f0reachARR/music-light-stick/xiao-sch/LightStick/LightStick.kicad_pcb

## KiCad design xiao-sch/LightStick/LightStick.kicad_pcb (2026-02-07)

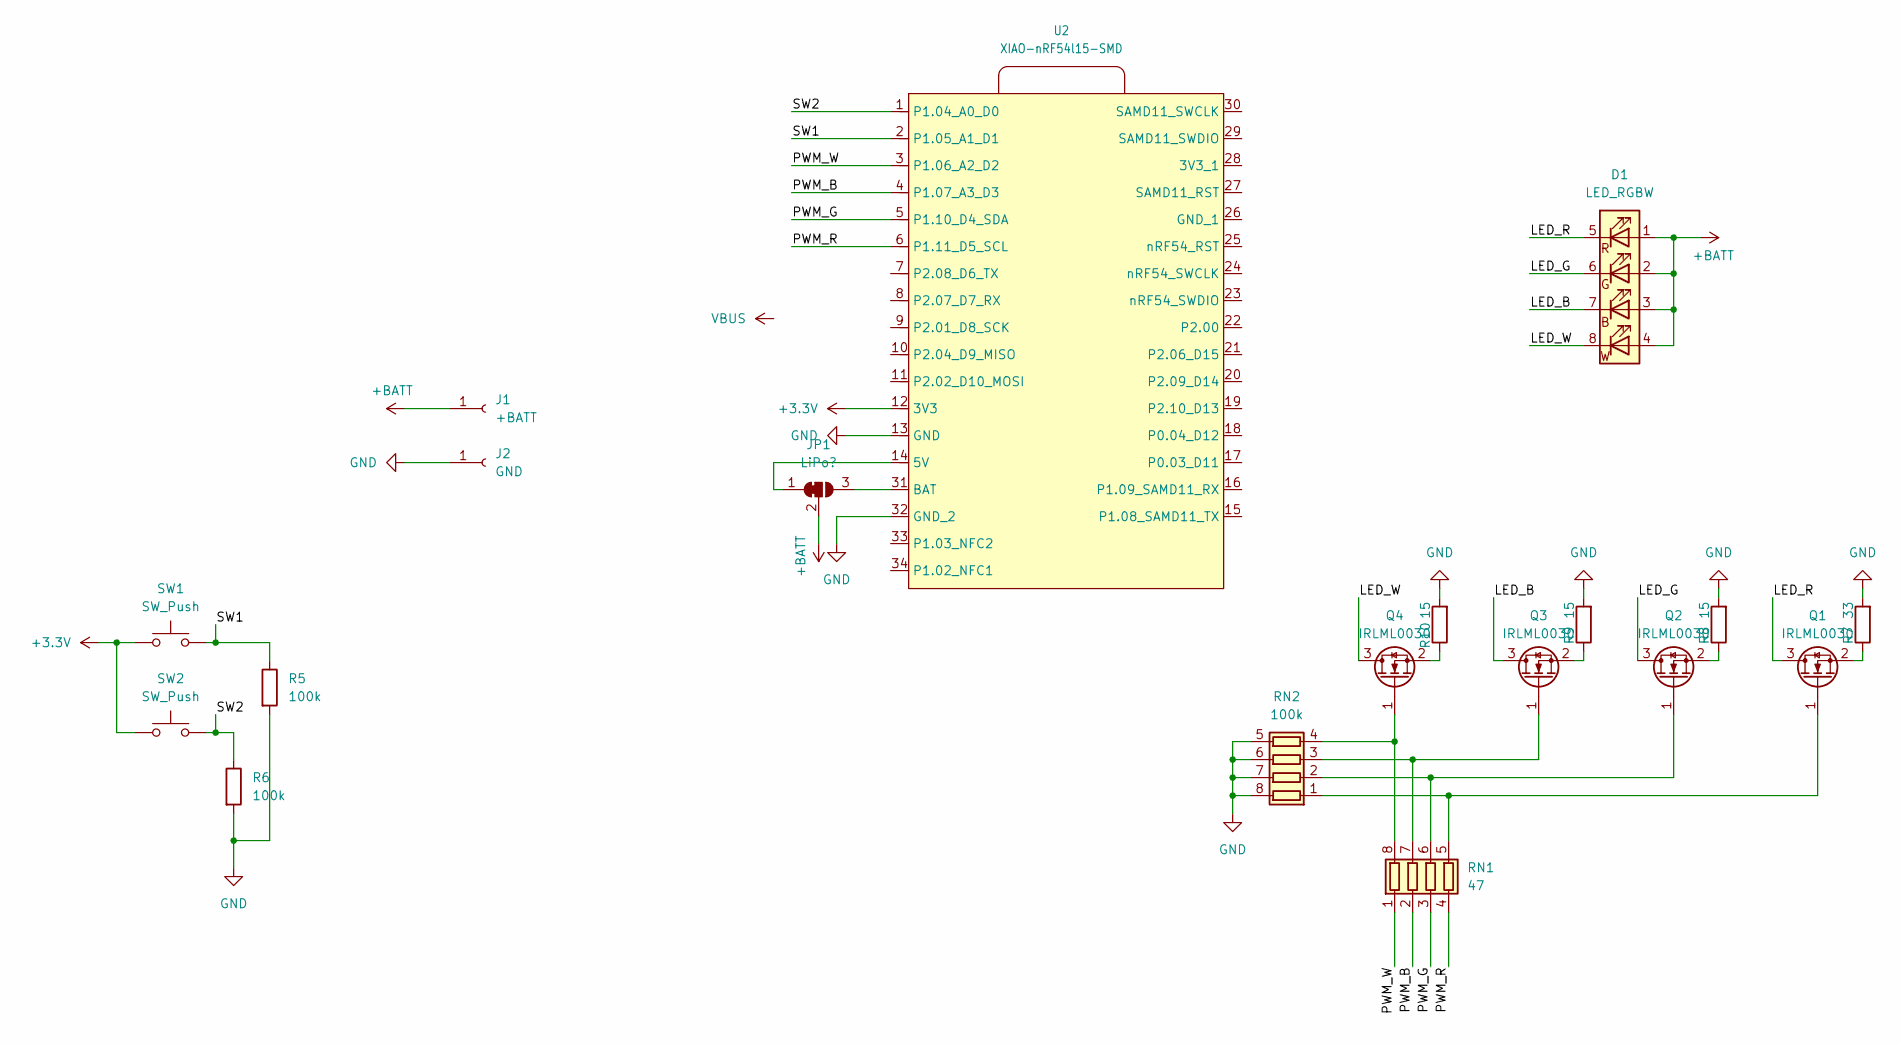
[picture p1: schematic LightStick.kicad_sch, LightStick Main]

Parts:
D1: LED_RGBW; XL-5050RGBW
J1: +BATT; TestPoint_Pad_D2.5mm
J2: GND; TestPoint_Pad_D2.5mm
JP1: LiPo?; SolderJumper-3_P1.3mm_Bridged12_RoundedPad1.0x1.5mm
Q1, Q2, Q3, Q4: IRLML0030; SOT-23
R5, R6: 100k; R_0603_1608Metric_Pad0.98x0.95mm_HandSolder
R7: 33; R_0603_1608Metric_Pad0.98x0.95mm_HandSolder
R8, R9, R10: 15; R_0603_1608Metric_Pad0.98x0.95mm_HandSolder
RN1: 47; R_Array_Concave_4x0603
RN2: 100k; R_Array_Concave_4x0603
SW1, SW2: SW_Push; SW_SPST_PTS647_Sx38
U2: XIAO-nRF54l15-SMD

Connections:
+3.3V: SW1.1, SW2.1, U2.12 (3V3)
+BATT: D1.1 (RA), D1.2 (GA), D1.3 (BA), D1.4 (WA), J1.1, JP1.2 (C)
/LED_B: D1.7 (BK), Q3.3 (D)
/LED_G: D1.6 (GK), Q2.3 (D)
/LED_R: D1.5 (RK), Q1.3 (D)
/LED_W: D1.8 (WK), Q4.3 (D)
/PWM_B: RN1.2 (R2.1), U2.4 (P1.07_A3_D3)
/PWM_G: RN1.3 (R3.1), U2.5 (P1.10_D4_SDA)
/PWM_R: RN1.4 (R4.1), U2.6 (P1.11_D5_SCL)
/PWM_W: RN1.1 (R1.1), U2.3 (P1.06_A2_D2)
/SW1: R5.1, SW1.2, U2.2 (P1.05_A1_D1)
/SW2: R6.1, SW2.2, U2.1 (P1.04_A0_D0)
GND: J2.1, R5.2, R6.2, R7.2, R8.2, R9.2, R10.2, RN2.5 (R4.2), RN2.6 (R3.2), RN2.7 (R2.2), RN2.8 (R1.2), U2.13 (GND), U2.32 (GND_2)
unnamed: JP1.1 (A), U2.14 (5V)
unnamed: JP1.3 (B), U2.31 (BAT)
unnamed: Q1.1 (G), RN1.5 (R4.2), RN2.1 (R1.1)
unnamed: Q1.2 (S), R7.1
unnamed: Q2.1 (G), RN1.6 (R3.2), RN2.2 (R2.1)
unnamed: Q2.2 (S), R8.1
unnamed: Q3.1 (G), RN1.7 (R2.2), RN2.3 (R3.1)
unnamed: Q3.2 (S), R9.1
unnamed: Q4.1 (G), RN1.8 (R1.2), RN2.4 (R4.1)
unnamed: Q4.2 (S), R10.1

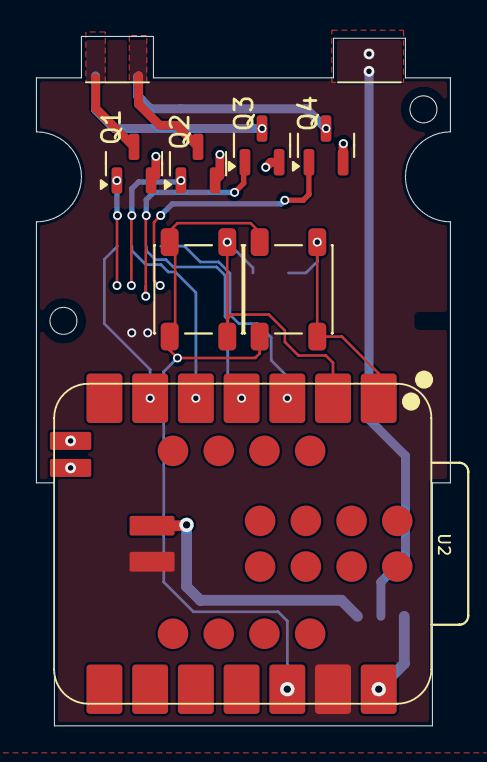
[picture p2: board LightStick.kicad_pcb from above]

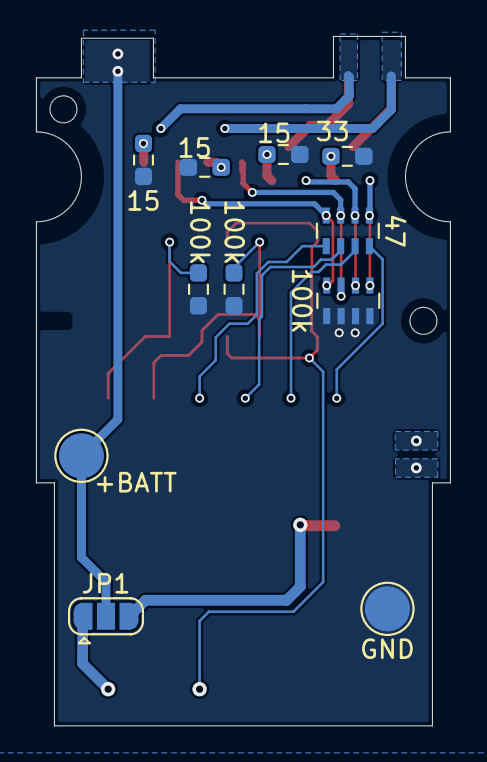
[picture p3: board LightStick.kicad_pcb from below]

Board: 2 copper layers, 23.0 x 38.3 mm, 18 parts (11 on the bottom side), 19 nets.
