f0reachARR/music-light-stick/olaf/olaf_fp_ref_mem.h

/**@file olaf_fp_ref_mem.h 
 * @brief The in-memory 'database' of fingerprints used to match queries against in the 'memory' configuration. 
 */
#include <stdint.h>

/**The array with fingerprints.*/
const uint64_t olaf_db_mem_fps[] = {
  5117970209,    5117976038,    5118171052,    5118303069,    5118365840,    5118367459,
  5118428527,    5118431430,    5118494693,    5118699386,    5118757247,    5118762572,
  5118821580,    5118953136,    5118957236,    5118965431,    5119030565,    5119085901,
  5119223812,    5119227247,    6175070423,    6175274332,    6175327579,    6175340068,
  6176114162,    6191717596,    6191842786,    6191847493,    6191847985,    6191854065,
  6191911323,    6191974093,    6192042203,    6192046058,    6192111470,    6192172687,
  6192181854,    6192303880,    6192444306,    6192763261,    6192827996,    7248618388,
  7248688318,    7248741645,    7248818348,    7248942110,    7248942801,    7249008062,
  7249009182,    7249011964,    7249012721,    7249012929,    7249071739,    7249336647,
  7249340051,    7249340737,    7249343198,    7249398873,    7249409347,    7249596844,
  7249601428,    7249602517,    7249662645,    7249671641,    7249928463,    7249933937,
  7265456556,    7265651876,    7265716881,    7265717754,    7265727660,    7265785297,
  7265792361,    7265793015,    7265979405,    7266117291,    7266245531,    7266375415,
  7266375509,    7266379355,    7266379667,    7266383293,    7266569722,    7266634385,
  7266638433,    7266641299,    7266645150,    8322421178,    8323008712,    8323215506,
  8339196579,    8339456436,    8339858888,    9396626867,    9396685288,    9413003953,
  9413921457,    10470359792,   10486949344,   10487474864,   10487599957,   11561012158,
  12617717059,   12617719388,   12634426163,   12634436570,   12634757865,   12635023478,
  12635026509,   12635151983,   13691133518,   13691264345,   13691453777,   13691860072,
  13691915356,   13692313148,   13692378278,   13692378702,   13708168737,   13708173661,
  13709029112,   14765008161,   14765267635,   14765658057,   14765662424,   14765860356,
  14781977147,   14782628942,   15856511776,   16912496161,   16913017801,   16913151267,
  16913270542,   16929795697,   16930114875,   16930374100,   19060560686,   20133717400,
  20133909687,   23372375392,   24446107952,   24446317648,   24446380154,   24446501480,
  25503147743,   25503203916,   25503407712,   25519335162,   25519587976,   25519793932,
  26592943279,   28724173531,   28740499070,   28740748443,   28741346924,   28741409523,
  29798108054,   29798507318,   30871331574,   30888897434,   33018553335,   33018752613,
  33019538457,   33035583958,   33035723014,   34092420296,   42699205928,   43756369082,
  43772750249,   72764688018,   73821070230,   75984876975,   75985859300,   75985925551,
  77042358635,   81337197585,   81353774972,   85649864029,   86705776822,   86705967347,
  86722357663,   86722484408,   86723340688,   86723405976,   96386034363,   97443318097,
  97444235601,   97460234953,   112475510067,  113549574701,  113565897264,  113565969995,
  113566881377,  113566952891,  114623196762,  114623654399,  114639769721,  114640167844,
  115696737744,  115697128878,  115697527874,  116770540343,  116787130998,  122155832789,
  127508424190,  127524670374,  127525062530,  127525718088,  128598215115,  128598743106,
  129655380055,  129655449982,  137188611919,  159738045572,  170475402619,  172622296741,
  175827395254,  176900420570,  177973959251,  193006088007,  198374920262,  202687524735,
  203744225205,  203761263385,  203761266151,  209129711009,  211260222260,  216628406279,
  224162291959,  227366142067,  227382600694,  228457383015,  229513823366,  230604081734,
  235956411950,  241342033683,  243489840091,  279996205184,  279996208025,  279996208176,
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
};
