f0reachARR/music-light-stick/olaf/olaf_window.h

// Olaf: Overly Lightweight Acoustic Fingerprinting
// Copyright (C) 2019-2025  Joren Six

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
#ifndef OLAF_WINDOW_H
#define OLAF_WINDOW_H

#include <stdbool.h>  //bool

/**
 * @file olaf_window.h
 * @brief Precomputed windows to apply to audio blocks.
 * 
 */

/**
 * @brief A pre calculated hamming window for an audio block of 1024 samples.
 * Meant to be applied before the FFT.
 * 
 * Construct e.g. with Numpy's signal.windows.hamming(1024). See https://docs.scipy.org/doc/scipy/reference/generated/scipy.signal.windows.hamming.html
 * 
 */
static const float hamming_window_1024[] = {
  0.08000000000000007, 0.08000867630758934, 0.08003470490305992,
  0.08007808480453332, 0.08013881437558612, 0.08021689132531201,
  0.08031231270840833, 0.08042507492528683, 0.08055517372220994,
  0.0807026041914507,  0.08086736077147827, 0.08104943724716751,
  0.08124882675003375, 0.08146552175849137, 0.08169951409813808,
  0.08195079494206298, 0.08221935481117948, 0.0825051835745832,
  0.08280827044993372, 0.0831286040038618,  0.08346617215240026,
  0.08382096216143986, 0.08419296064721021, 0.08458215357678378,
  0.08498852626860603, 0.0854120633930488,  0.08585274897298867,
  0.08631056638440998, 0.08678549835703142, 0.08727752697495778,
  0.08778663367735601, 0.08831279925915503, 0.08885600387177028,
  0.0894162270238526,  0.08999344758206129, 0.09058764377186107,
  0.0911987931783435,  0.09182687274707296, 0.09247185878495578,
  0.09313372696113431, 0.09381245230790469, 0.0945080092216588,
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
{
  if (audioBlockSize == 512) {
    return hamming_window_512;
  } else if (audioBlockSize == 1024) {
    return hamming_window_1024;
  }
  fprintf(stderr, "Window of size %d not supported.\n", audioBlockSize);
  // assert(false);
  return NULL;
}

#endif  // OLAF_WINDOW_H
