f0reachARR/music-light-stick/olaf/olaf_db.hpp

// Olaf: Overly Lightweight Acoustic Fingerprinting
// Copyright (C) 2019-2025  Joren Six

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
#ifndef OLAF_DB_HPP
#define OLAF_DB_HPP

#include <algorithm>
#include <cstdint>
#include <cstdio>
#include <cstring>
#include <span>
#include <vector>

namespace olaf
{

/**
 * @struct AudioReference
 * @brief Reference to a single audio file's fingerprint array
 */
struct AudioReference
{
  std::uint32_t audio_id;
  std::span<const std::uint64_t> fingerprints;
};

/**
 * @class DB
 * @brief In-memory fingerprint database supporting multiple audio files
 *
 * Each audio file is represented by a static array like olaf_db_mem_fps[].
 * The database stores pointers to these arrays without copying data.
 */
class DB
{
private:
  // List of audio references (no heap allocation for fingerprint data)
  std::vector<AudioReference> audio_refs_;

  static void unpack(std::uint64_t packed, std::uint64_t & hash, std::uint32_t & timestamp)
  {
    hash = (packed >> 16);
    timestamp = static_cast<std::uint32_t>(static_cast<std::uint16_t>(packed));
  }

  static std::uint64_t pack(std::uint64_t hash, std::uint32_t timestamp)
  {
    return (hash << 16) + (timestamp & 0xFFFF);
  }

public:
  explicit DB() {}

  /**
     * @brief Register a static fingerprint array for an audio file
     * @param audio_id Unique identifier for this audio
     * @param fingerprints Pointer to static array of packed fingerprints
     * @param fp_length Number of fingerprints in array
     * @param path Audio file path
     * @param duration Audio duration in seconds
     */
  void register_audio(
    std::uint32_t audio_id, const std::uint64_t * fingerprints, std::size_t fp_length)
  {
    AudioReference ref;
    ref.audio_id = audio_id;
    ref.fingerprints = std::span<const std::uint64_t>(fingerprints, fp_length);

    audio_refs_.push_back(ref);

    std::fprintf(stderr, "Registered audio ID %u (%zu fingerprints)\n", audio_id, fp_length);
  }

  /**
     * @brief Find fingerprints across all registered audio files
     * @param start_key Start hash (inclusive)
     * @param stop_key Stop hash (inclusive)
     * @param results Output vector (timestamp << 32 | audio_id)
     * @param max_results Maximum results to find
     * @return Number of results found
     */
  std::size_t find(
    std::uint64_t start_key, std::uint64_t stop_key, std::vector<std::uint64_t> & results,
    std::size_t max_results) const
  {
    results.clear();

    // Search through each audio file
    for (const auto & audio_ref : audio_refs_) {
      auto match_it = audio_ref.fingerprints.end();

      // Binary search for any key in range within this audio's fingerprints
      for (std::uint64_t current_key = start_key; current_key <= stop_key; ++current_key) {
        const std::uint64_t packed_key = pack(current_key, 0);

        // Binary search in sorted array
        auto it = std::lower_bound(
          audio_ref.fingerprints.begin(), audio_ref.fingerprints.end(), packed_key,
          [](std::uint64_t a, std::uint64_t b) { return (a >> 16) < (b >> 16); });

        if (it != audio_ref.fingerprints.end() && ((*it) >> 16) == (packed_key >> 16)) {
          match_it = it;
          break;
        }
      }

      if (match_it != audio_ref.fingerprints.end()) {
        // Find all collisions (same hash range, different timestamps)
        const std::size_t index = std::distance(audio_ref.fingerprints.begin(), match_it);

        // Search backwards from match
        for (std::size_t i = index; i < audio_ref.fingerprints.size(); --i) {
          std::uint64_t ref_hash;
          std::uint32_t ref_t;
          unpack(audio_ref.fingerprints[i], ref_hash, ref_t);

          if (ref_hash >= start_key && ref_hash <= stop_key) {
            if (results.size() < max_results) {
              const std::uint64_t t = ref_t;
              results.push_back((t << 32) | audio_ref.audio_id);
            } else {
              std::fprintf(stderr, "Warning: Max results %zu reached\n", max_results);
              return results.size();
            }
          } else {
            break;
          }

          if (i == 0) break;  // Prevent underflow
        }

        // Search forwards from match
        for (std::size_t i = index + 1; i < audio_ref.fingerprints.size(); ++i) {
          std::uint64_t ref_hash;
          std::uint32_t ref_t;
          unpack(audio_ref.fingerprints[i], ref_hash, ref_t);

          if (ref_hash >= start_key && ref_hash <= stop_key) {
            if (results.size() < max_results) {
              const std::uint64_t t = ref_t;
              results.push_back((t << 32) | audio_ref.audio_id);
            } else {
              std::fprintf(stderr, "Warning: Max results %zu reached\n", max_results);
              return results.size();
            }
          } else {
            break;
          }
        }
      }
    }

    return results.size();
  }

  /**
     * @brief Check if any fingerprint exists in range across all audio files
     */
  bool find_single(std::uint64_t start_key, std::uint64_t stop_key) const
  {
    for (const auto & audio_ref : audio_refs_) {
      for (const auto & packed : audio_ref.fingerprints) {
        std::uint64_t ref_hash;
        std::uint32_t ref_t;
        unpack(packed, ref_hash, ref_t);

        if (ref_hash < start_key) continue;
        if (ref_hash > stop_key) break;

        return true;  // Found hash in range
      }
    }
    return false;
  }

  /**
     * @brief Remove registered audio file
     */
  void delete_audio(std::uint32_t audio_id)
  {
    audio_refs_.erase(
      std::remove_if(
        audio_refs_.begin(), audio_refs_.end(),
        [audio_id](const AudioReference & ref) { return ref.audio_id == audio_id; }),
      audio_refs_.end());
  }

  /**
     * @brief Get database statistics
     */
  void print_stats(bool verbose = false) const
  {
    std::size_t total_fingerprints = 0;
    for (const auto & ref : audio_refs_) {
      total_fingerprints += ref.fingerprints.size();
    }

    std::printf("Database Statistics:\n");
    std::printf("  Total audio files: %zu\n", audio_refs_.size());
    std::printf("  Total fingerprints: %zu\n", total_fingerprints);

    if (verbose) {
      std::printf("\nRegistered audio files:\n");
      for (const auto & ref : audio_refs_) {
        std::printf("  ID %u:\n", ref.audio_id);
      }
    }
  }

  /**
     * @brief Simple string hash (Jenkins hash)
     */
  static std::uint32_t string_hash(const char * key, std::size_t len)
  {
    std::uint32_t hash = 0;
    for (std::size_t i = 0; i < len; ++i) {
      hash += static_cast<std::uint32_t>(key[i]);
      hash += (hash << 10);
      hash ^= (hash >> 6);
    }
    hash += (hash << 3);
    hash ^= (hash >> 11);
    hash += (hash << 15);
    return hash;
  }

  // Utility methods

  std::size_t get_audio_count() const { return audio_refs_.size(); }

  std::size_t get_total_fingerprints() const
  {
    std::size_t total = 0;
    for (const auto & ref : audio_refs_) {
      total += ref.fingerprints.size();
    }
    return total;
  }

  void clear() { audio_refs_.clear(); }
};

}  // namespace olaf

#endif  // OLAF_DB_HPP
