f0reachARR/music-light-stick/(commit log)

2025-10-11 Add XIAO based board
    [LightStick-LED.kicad_pcb, LightStick-LED.kicad_sch, LightStick.kicad_pcb, LightStick.kicad_sch]
2025-10-12 Raytac Module version
    [LightStick-MIC.kicad_pcb, LightStick-MIC.kicad_sch, LightStick.kicad_pcb, LightStick.kicad_sch]
2025-10-25 Dual button
2026-02-07 xiao wip
    [LightStick-LED.kicad_pcb, LightStick-LED.kicad_sch, LightStick.kicad_pcb, LightStick.kicad_sch]
